solich919/slckb_project/README.md

# slckb_project
Keyboard project based on AVR
