solich919/slckb_project/doc/img/pcb_.jpg

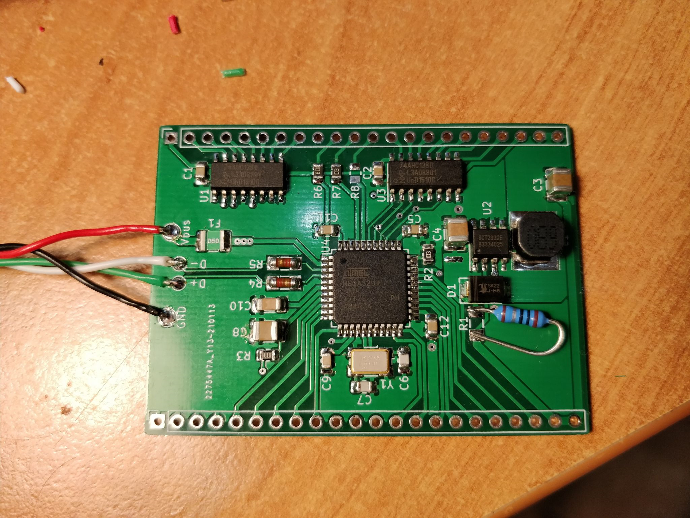
doc/img/pcb_.jpg
