solich919/slckb_project/doc/img/slckb.pdf

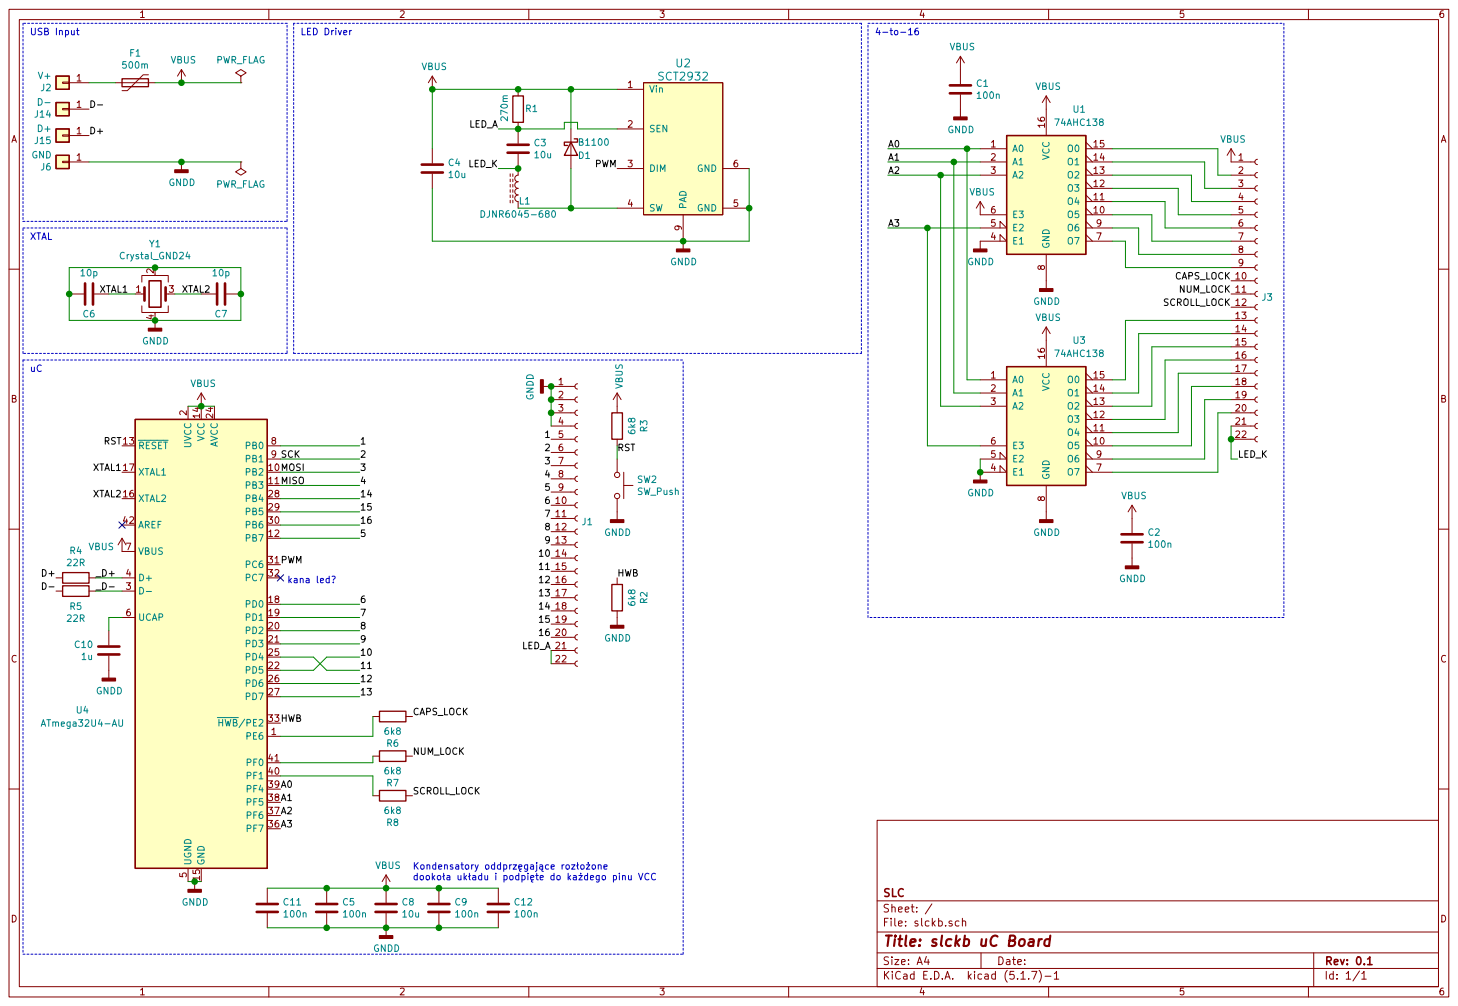
[picture p13: page 1]

dookoa ukadu i podpite do kadego pinu VCC

Id: 1/1 Title: slckb uC Board
