solich919/slckb_project/kicad/slckb/slckb.kicad_pcb

## KiCad design kicad/slckb/slckb.kicad_pcb (2022-05-15)

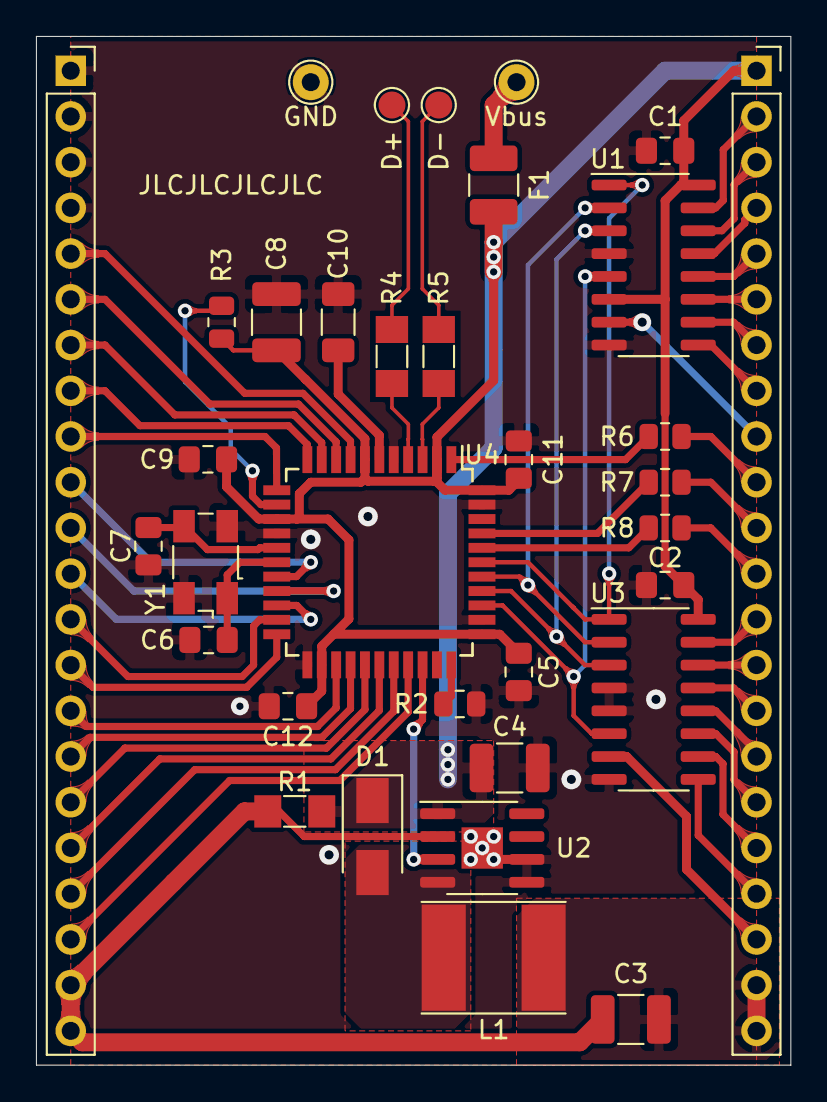
[picture p16: board slckb.kicad_pcb from above]

Board: 2 copper layers, 41.9 x 57.1 mm, 35 parts (1 on the bottom side), 58 nets.

Parts:
C1, C2, C5, C9, C11, C12: 100n; C_0805_2012Metric_Pad1.18x1.45mm_HandSolder
C3, C4, C8: 10u; C_1210_3225Metric_Pad1.33x2.70mm_HandSolder
C6, C7: 10p; C_0805_2012Metric_Pad1.18x1.45mm_HandSolder
C10: 1u; C_1206_3216Metric_Pad1.33x1.80mm_HandSolder
D1: B1100; D_SMA
D+: Conn_01x01; TestPoint_Pad_D1.5mm
D-: Conn_01x01; TestPoint_Pad_D1.5mm
F1: 500m; Fuse_1210_3225Metric_Pad1.42x2.65mm_HandSolder
GND: Conn_01x01; TestPoint_THTPad_D2.0mm_Drill1.0mm
J1, J3: Conn_01x22_Female; PinSocket_1x22_P2.54mm_Vertical
L1: DJNR6045-680; L_Taiyo-Yuden_NR-60xx_HandSoldering
R1: 270m; R_MiniMELF_MMA-0204
R2, R3, R6, R7, R8: 6k8; R_0805_2012Metric
R4, R5: 22R; R_MiniMELF_MMA-0204
SW2: SW_Push; SW_SPST_FSMSM
U1, U3: 74AHC138; SOIC-16_3.9x9.9mm_P1.27mm
U2: SCT2932; HSOP-8-1EP_3.9x4.9mm_P1.27mm_EP2.3x2.3mm
U4: ATmega32U4-AU; TQFP-44_10x10mm_P0.8mm
Vbus: Conn_01x01; TestPoint_THTPad_D2.0mm_Drill1.0mm
Y1: Crystal_GND24; Crystal_SMD_Abracon_ABM3B-4Pin_5.0x3.2mm

Connections:
/1: J1.5, U4.8
/2: J1.6, U4.9
/3: J1.7, U4.10
/4: J1.8, U4.11
/5: J1.9, U4.12
/6: J1.10, U4.18
/7: J1.11, U4.19
/8: J1.12, U4.20
/9: J1.13, U4.21
/10: J1.14, U4.22
/11: J1.15, U4.25
/12: J1.16, U4.26
/13: J1.17, U4.27
/14: J1.18, U4.28
/15: J1.19, U4.29
/16: J1.20, U4.30
/A0: U1.1, U3.1, U4.39
/A1: U1.2, U3.2, U4.38
/A2: U1.3, U3.3, U4.37
/A3: U1.5, U3.6, U4.36
/CAPS_LOCK: J3.10, R6.2
/D+: D+.1, R4.2
/D-: D-.1, R5.2
/HWB: R2.2, U4.33
/LED_A: C3.1, J1.21, J1.22, R1.1, U2.2
/LED_K: C3.2, J3.21, J3.22, L1.1
/NUM_LOCK: J3.11, R7.2
/PWM: U2.3, U4.31
/RST: R3.1, SW2.1, U4.13
/SCROLL_LOCK: J3.12, R8.2
/XTAL1: C6.1, U4.17, Y1.1
/XTAL2: C7.2, U4.16, Y1.3
/_D+: R4.1, U4.4
/_D-: R5.1, U4.3
GNDD: C1.2, C2.2, C4.2, C5.2, C6.2, C7.1, C8.2, C9.2, C10.2, C11.2, C12.2, GND.1, J1.1, J1.2, J1.3, J1.4, R2.1, SW2.2, U1.4, U1.8, U2.5, U2.6, U2.9, U3.4, U3.5, U3.8, U4.5, U4.15, U4.23, U4.35, U4.43, Y1.2, Y1.4
unnamed: C10.1, U4.6
unnamed: D1.2, L1.2, U2.4
unnamed: F1.2, Vbus.1
unnamed: J3.2, U1.15
unnamed: J3.3, U1.14
unnamed: J3.4, U1.13
unnamed: J3.5, U1.12
unnamed: J3.6, U1.11
unnamed: J3.7, U1.10
unnamed: J3.8, U1.9
unnamed: J3.9, U1.7
unnamed: J3.13, U3.15
unnamed: J3.14, U3.14
unnamed: J3.15, U3.13
unnamed: J3.16, U3.12
unnamed: J3.17, U3.11
unnamed: J3.18, U3.10
unnamed: J3.19, U3.9
unnamed: J3.20, U3.7
unnamed: R6.1, U4.1
unnamed: R7.1, U4.41
unnamed: R8.1, U4.40
VBUS: C1.1, C2.1, C4.1, C5.1, C8.1, C9.1, C11.1, C12.1, D1.1, F1.1, J3.1, R1.2, R3.2, U1.6, U1.16, U2.1, U3.16, U4.2, U4.7, U4.14, U4.24, U4.34, U4.44
