solich919/slckb_project/(commit log)

2020-11-03 added TKL pcb schematics
    [sw_pcb.kicad_pcb, sw_pcb.sch]
2020-11-04 removed bak files, updated TODO
    [slckb.sch]
2020-11-04 general update
    [slckb.sch]
2020-11-17 some updates
    [slckb.sch, sw_pcb.kicad_pcb, sw_pcb.sch]
2020-11-29 seperated uart functions
